waldo2188/greenhouse-arduino/README.md

iot Greenhouse
==============

Monitored greenhouse for tastiest vegetable.

# Part list

| Name | Description | Part Information | Quantity |
|---|---|---|---|
| Arduino | | Ardiono Mega | 1 |
| Tiny RTC i2C | Real time clock module for arduino | [Arduino Tiny RTC I2C real time clock module 24C32 storage DS1307](http://smart-prototyping.com/Arduino-Tiny-RTC-I2C-real-time-clock-module-24C32-storage-DS1307.html) | 1 |
| DS18B20 | Temperature sensor | [DS18B20](http://www.banggood.com/fr/DS18B20-Waterproof-Digital-Temperature-Temp-Sensor-Probe-1M-2M-3M-5M-10M-15M-p-983801.html) | 1 |
| Fan | Just a regular fan | Fan 12V 0.14A | 1 |
| Pump | | [Mini DC12V 3M Micro Quiet Brushless MotorSubmersible Water Pump](http://www.banggood.com/fr/Mini-DC12V-3M-Micro-Quiet-Brushless-Motor-Submersible-Water-Pump-p-932046.html) | 1 |
| Growing Led | | [1M 2M 3M 4M 5M 4:1 5050 SMD LED HydroponicPlant Grow Strip Light 12V](http://www.banggood.com/fr/1M-2M-3M-4M-5M-41-5050-SMD-LED-Hydroponic-Plant-Grow-Strip-Light-12V-p-973918.html) | 1 |
| Mosfet | | IRFZ44N Transistor N-Channel Rectifier PowerMosfet | 4 |
| Power Supply Converter | | 3Pcs 5A XL4005 DC-DC Adjustable Step Down Module Power Supply Converter | 1 |
| Moisture Sensor | | [Moisture Sensor](http://www.banggood.com/Moisture-Sensor-For-Arduino-Automatic-Watering-System-p-995384.html)| 1 |
| AM2302, DHT22 | Temperature And Humidity Sensor | [AM2302 DHT22 Temperature And Humidity Sensor](http://www.banggood.com/AM2302-DHT22-Temperature-And-Humidity-Sensor-Module-For-Arduino-SCM-p-937403.html) | 1 |
| Hall Magnetic Sensor | | DC 5V KY-003 Hall Magnetic Sensor Module ForArduino | 1 |
| Photoresistor | | Photoresistor | 1 |
| ESP Adapter | Adapter Module 3.3V / 5V | ESP-01 Adapter Open Smart- ESP8266 Serial Wifi Wireless ESP-01 Adapter Module 3.3V / 5V | 1 |
| ESP8266 Wifi | Wifi module | OPEN-SMART ESP-01 ESP8266 Serial Wi-Fi Wireless Module | 1 |

# Required library

This project require additionnal libraries that you have to get : 
 * [bportaluri/WiFiEsp](https://github.com/bportaluri/WiFiEsp)
 * [OneWire](http://www.pjrc.com/teensy/td_libs_OneWire.html)
 * [DallasTemperature](https://github.com/milesburton/Arduino-Temperature-Control-Library)
 * [RTCLib](https://github.com/adafruit/RTClib.git)
