waldo2188/greenhouse-arduino/docs/bottomcopper.PNG

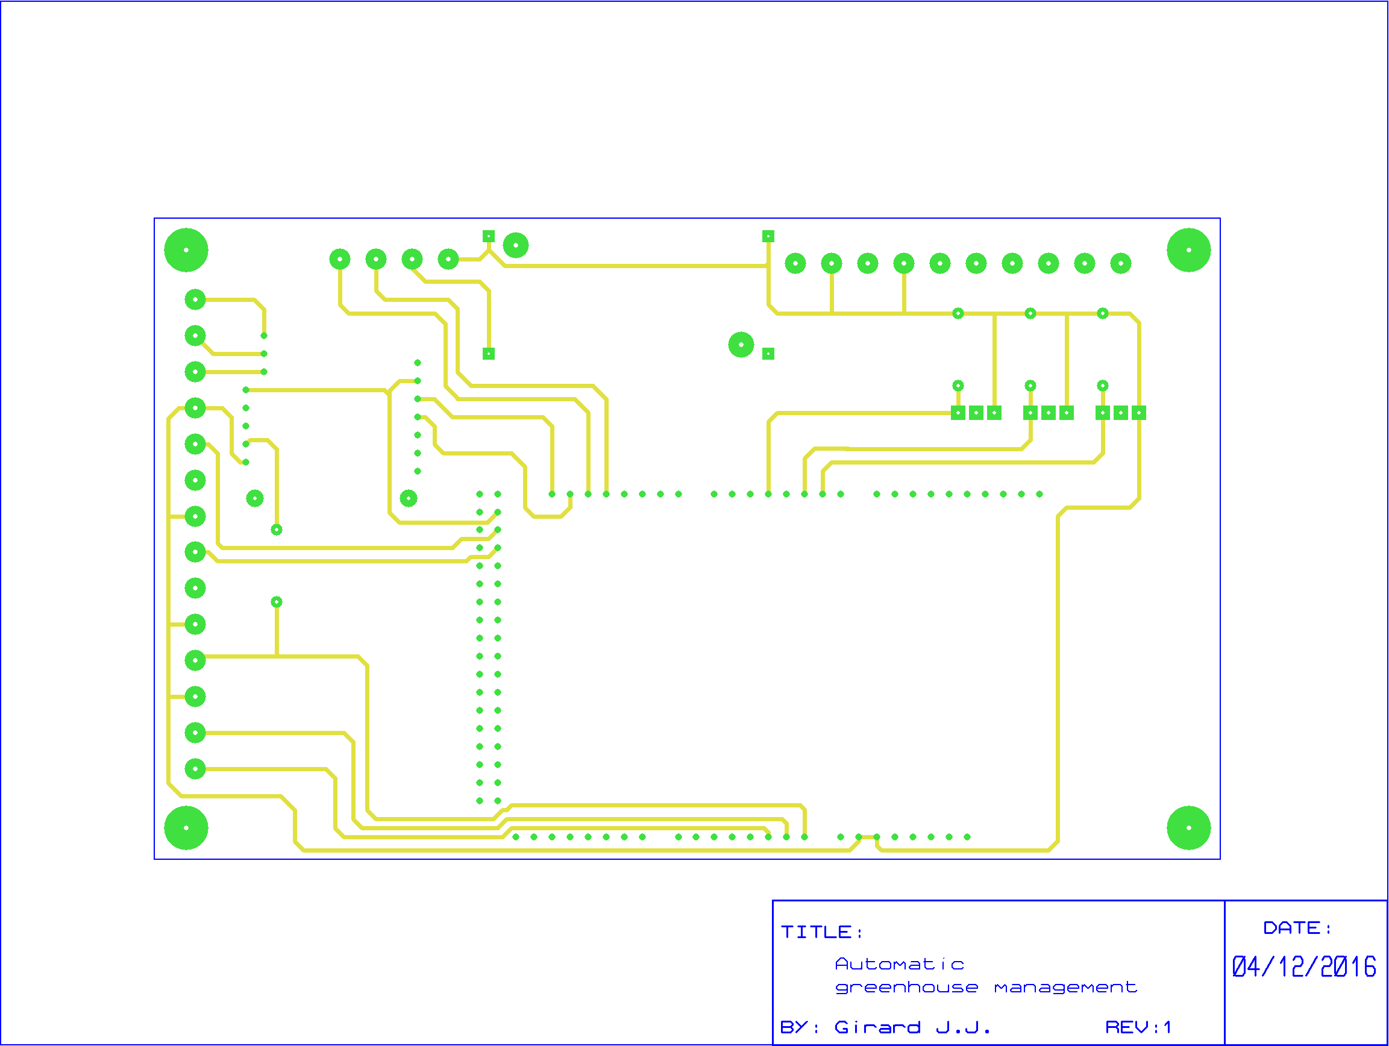
docs/bottomcopper.PNG
