waldo2188/greenhouse-arduino/docs/global.PNG

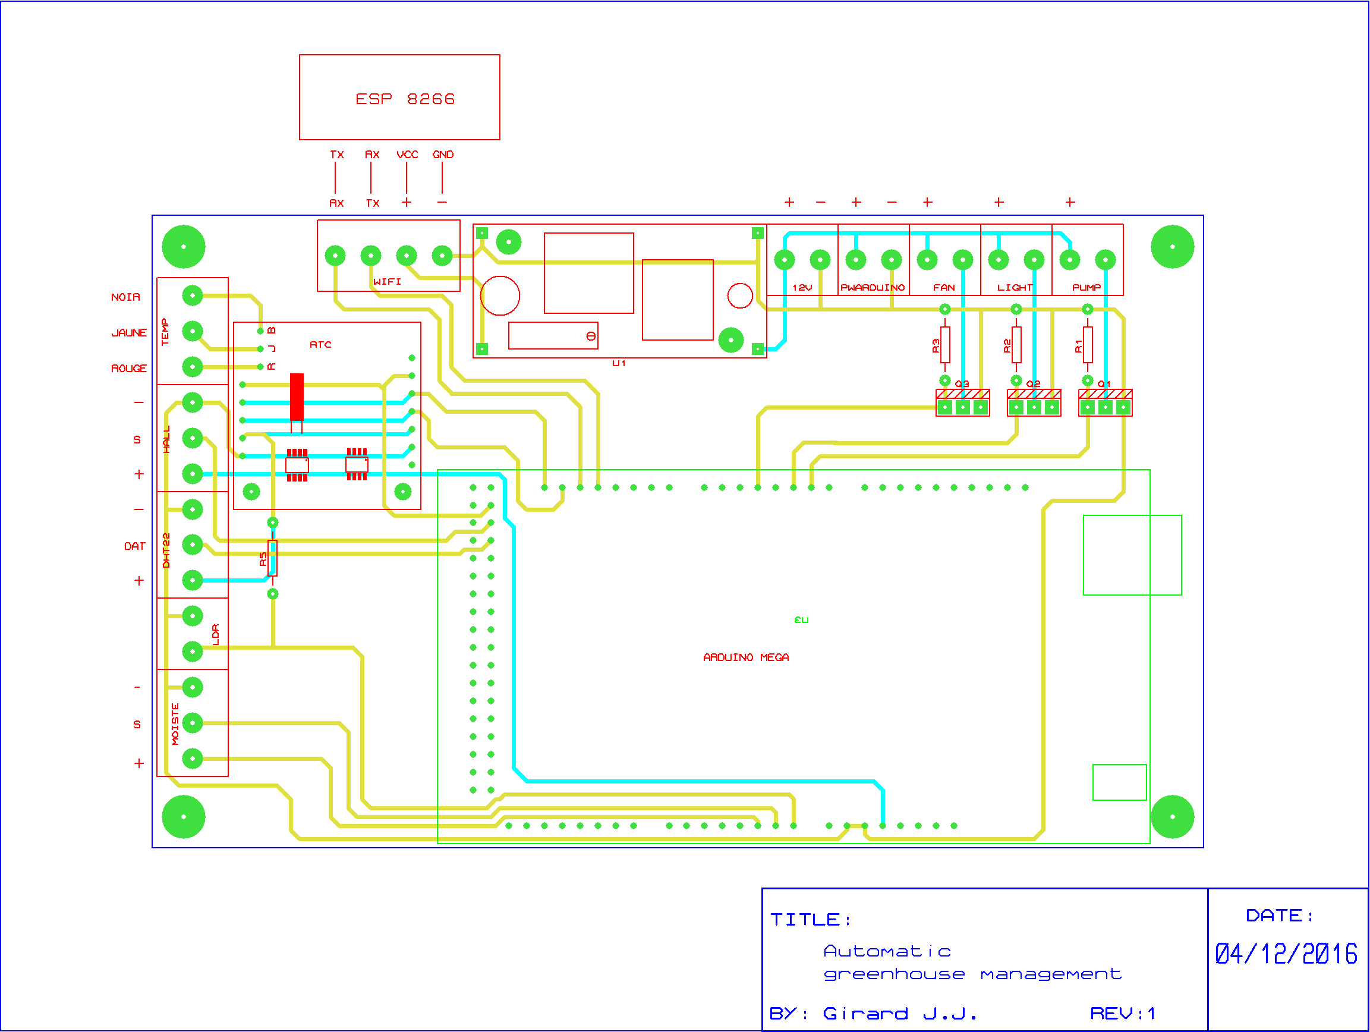
docs/global.PNG
