waldo2188/greenhouse-arduino/docs/topsilk.PNG

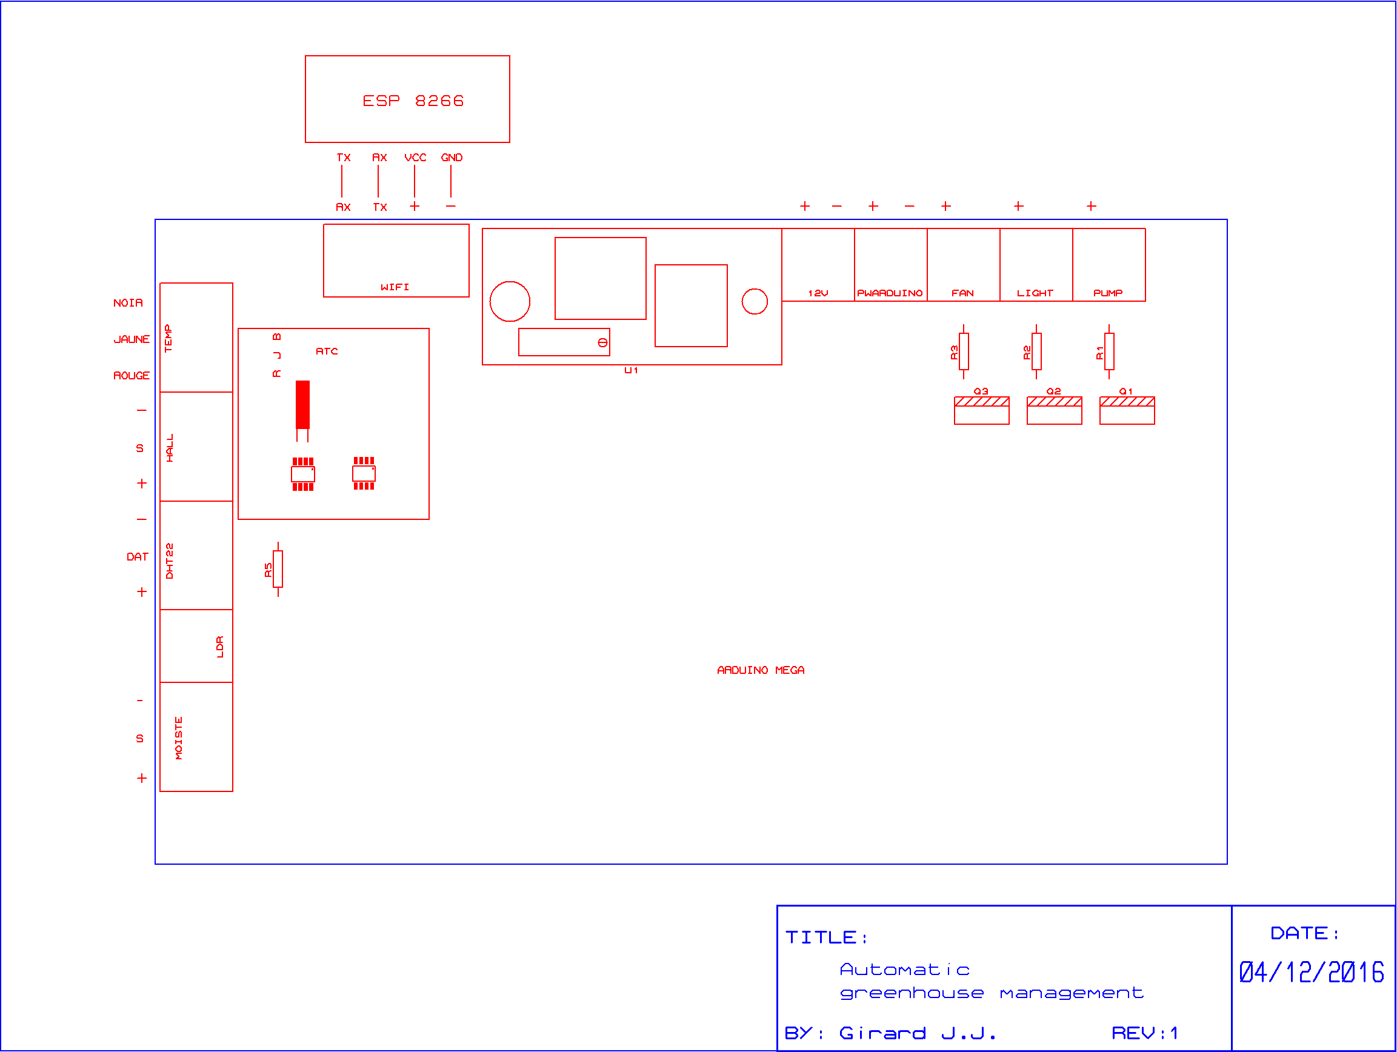
docs/topsilk.PNG
