waldo2188/greenhouse-arduino/(commit log)

2016-07-22 Wire temperature and humidity sensor
2016-07-23 Add the ability to drive a fan
2016-07-31 Add the managment of water pump
2016-12-18 Match port with first electronic prototype
2016-12-21 Fix wifi crash issue
    [GreenHouse.ino, GreenWifi.cpp, GreenWifi.h, RealTimeClock.cpp, RealTimeClock.h]
2016-12-21 Diagram of electronic circuits
2016-12-22 Fix low temp bug
    [ManageTemperatureHumidity.cpp]
2017-02-16 Fix bug in watering
    [GreenHouse.ino, RealTimeClock.cpp, RealTimeClock.h, Watering.cpp, Watering.h]
2017-02-18 Try to have more accurate result with the moisture sensor
2017-02-18 Try a lower threshold for the moisture sensor
2017-02-26 Smooth the moisture sensor value
